cebollinverde/robot-manipulador/docs/diagrama_conexiones.png

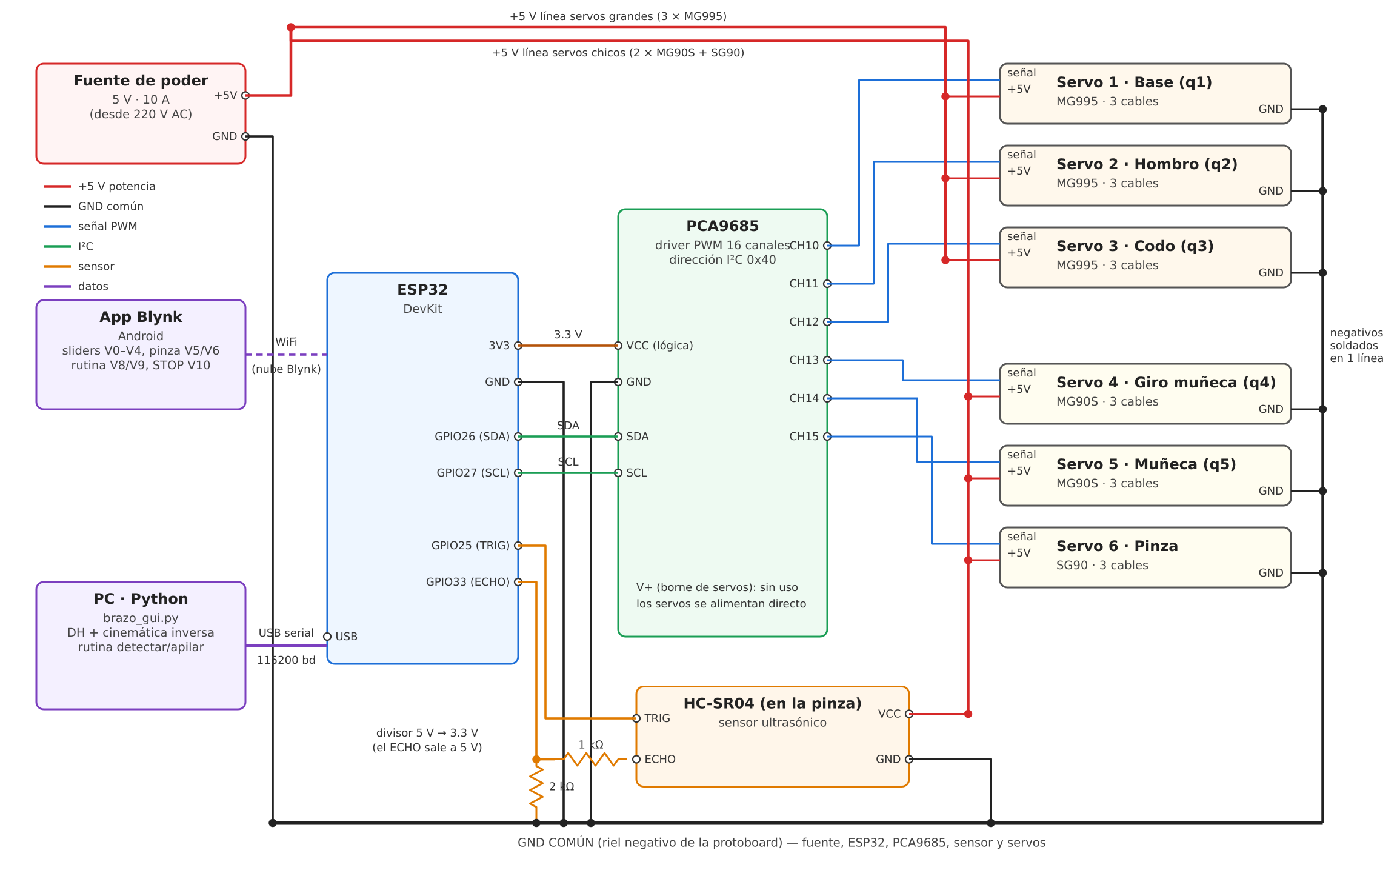
docs/diagrama_conexiones.png
