cebollinverde/robot-manipulador/(commit log)

2026-11-06 feat: agregar apilado enseñado de dos cajas
    - guarda la calibración física A-B y la trayectoria validada
    - añade Rutina 4 con HC-SR04, espera segura y velocidad 20
    - incorpora la corrección final de 5 mm para alinear la segunda caja
    - separa credenciales Blynk/WiFi y documenta la evolución del proyecto
2026-11-06 feat: completar panel y respaldo de Blynk
    Publica la configuración V0-V18, documenta la rutina de dos cajas y corrige la sincronización de velocidad al reconectar.
    [Manipulador.ino, rutina.py]
2026-11-06 feat: elevar aproximacion y acelerar apilado
    Eleva 1 cm la espera sobre A, ajusta el umbral del HC-SR04, aumenta la rutina a velocidad 30 y añade soporte reproducible de PlatformIO.
2026-11-06 fix: ejecutar apilado Blynk directamente en ESP32
    [Manipulador.ino]
